linlingwanqing-commits/tp78_v2/mounriver_project/KEYBOARD_CH582M/HAL/include/HAL.h

#define __HAL_H
#ifdef __cplusplus
extern "C"
{
#endif
#include "CH58x_common.h"
typedef union {
    struct {
        unsigned char LeftBtn : 1;
        unsigned char RightBtn : 1;
        unsigned char MiddleBtn : 1;
        unsigned char Always1 : 1;
        unsigned char Xsignbit : 1;
        unsigned char Xspinbit : 1;
        unsigned char Xoverflow : 1;
        unsigned char Yoverflow : 1;
        signed char XMovement : 8;
        signed char YMovement : 8;
        signed char ZMovement : 8;
    };
    uint8_t data[4];
}Mouse_Data_t;
typedef union {
    struct {
        unsigned char LeftCTRL : 1;
        unsigned char LeftShift : 1;
        unsigned char LeftAlt : 1;
        unsigned char LeftGUI : 1;
        unsigned char RightCTRL : 1;
        unsigned char RightShift : 1;
        unsigned char RightAlt : 1;
        unsigned char RightGUI : 1;
        unsigned char Reserved : 8;
        unsigned char Key1 : 8;
        unsigned char Key2 : 8;
        unsigned char Key3 : 8;
        unsigned char Key4 : 8;
        unsigned char Key5 : 8;
        unsigned char Key6 : 8;
        };
    uint8_t data[8];
}Keyboard_Data_t;
#define MouseDat        ((Mouse_Data_t*)HIDMouse)
#define KeyboardDat     ((Keyboard_Data_t*)HIDKeyboard)
#include "config.h"
#include "TP78_MPR121_LIB.h"
#include "TP78_TPM_LIB.h"
#include "RTC.h"
#include "SLEEP.h"
#include "LED.h"
#include "KEY.h"
#include "BLE.h"
#include "FATFS.h"
#include "USB.h"
#include "PS2.h"
#include "HW_I2C.h"
#include "I2C_TP.h"
#include "MPR121.h"
#include "OLED.h"
#include "OLED_UI.h"
#include "RF_PHY.h"
#include "KEYBOARD.h"
#include "BATTERY.h"
#include "WS2812.h"
#include "LIGHTMAP.h"
#include "CORE.h"
#define MAIN_CIRCULATION_EVENT              0x0001
#define HAL_MOUSE_EVENT                     0x0002
#define HAL_KEYBOARD_EVENT                  0x0004
#define HAL_TOUCHBAR_EVENT                  0x0008
#define BATTERY_EVENT                       0x0010
#define WS2812_EVENT                        0x0020
#define OLED_UI_EVENT                       0x0040
#define MPR121_EVENT                        0x0080
#define MOTOR_STOP_EVENT                    0x0200
#define TPM_EVENT                           0x0400
#define HAL_REG_INIT_EVENT                  0x1000
#define HAL_TEST_EVENT                      0x2000
#define MESSAGE_UART                        0xD0    // UART message
#define UART0_MESSAGE                       (MESSAGE_UART|0 )    // UART0 message
#define UART1_MESSAGE                       (MESSAGE_UART|1 )    // UART1 message
#define USB_MESSAGE              		        0xB0    // USB message
#define KEY_MESSAGE                         0xA0    // KEY message
#define MOUSE_MESSAGE                       0xA1    // MOUSE message
#define VOL_MESSAGE                         0xA2    // VOL message
#define SWITCH_MESSAGE                      0xA3    // SWITCH message
#define HEARTBEAT_MESSAGE                   0xAA    // HEARTBEAT message
#define PASSKEY_MESSAGE                     0xC0    // passkey message
#define USB_WORK_MODE                       0
#define BLE_WORK_MODE                       1
#define RF_WORK_MODE                        2
#define USB_WITH_BLE_WORK_MODE              3
#define HID_KEYBOARD_DATA_LENGTH            8
#define HID_MOUSE_DATA_LENGTH               4
#define HID_VOLUME_DATA_LENGTH              1
#define HID_SWITCH_DATA_LENGTH              2
#define HID_DATA_LENGTH                     19
#define CODEFLASH_ADDR_START                (0x50000)
#define CODEFLASH_LENGTH                    (0x18000)     // 结束地址0x67FFF(预留0x7FFF)
#define SYS_PERIOD                          50            // 系统任务周期, 单位1ms
#define WS2812_TASK_PERIOD_MS               80            // WS2812任务周期, 单位1ms
#define DEFAULT_IDLE_MAX_PERIOD             (180 * (1000 / SYS_PERIOD)) // idle_cnt大于该值则进入屏保
#define DEFAULT_LP_MAX_PERIOD               (240 * (1000 / SYS_PERIOD)) // idle_cnt大于该值则进入低功耗模式
#define MOTOR_PIN                           GPIO_Pin_19
#define MOTOR_RUN()                         { if (g_Enable_Status.motor == TRUE) GPIOB_SetBits( MOTOR_PIN ); }
#define MOTOR_STOP()                        { GPIOB_ResetBits( MOTOR_PIN ); }
#define MOTOR_Init()                        { MOTOR_STOP(); GPIOB_ModeCfg( MOTOR_PIN, GPIO_ModeOut_PP_5mA ); }
#define MOTOR_GO()                          { MOTOR_RUN(); tmos_start_task( halTaskID, MOTOR_STOP_EVENT, MS1_TO_SYSTEM_TIME(100) ); }
#define USB_CAPSLOCK_LEDON_BIT              0x1
#define BLE_CAPSLOCK_LEDON_BIT              0x2
#define RF_CAPSLOCK_LEDON_BIT               0x4
#define UI_CAPSLOCK_LEDON_BIT               0x80
#define HOST_SYS_WINDOWS_LINUX              0x0
#define HOST_SYS_MAC                        0x1
typedef struct tag_uart_package
{
  tmos_event_hdr_t hdr;
  uint8            *pData;
} uartPacket_t;
typedef struct  SendMSG
{
  tmos_event_hdr_t hdr;
  void            *pData;
} SendMSG_t;
typedef struct _CapsLock_LEDOn_Status_t
{
    uint8_t usb : 1;
    uint8_t ble : 1;
    uint8_t rf : 1;
    uint8_t reserved : 4;
    uint8_t ui : 1;
}CapsLock_LEDOn_Status_t;
typedef struct _NumLock_LEDOn_Status_t
{
    uint8_t usb : 1;
    uint8_t ble : 1;
    uint8_t rf : 1;
    uint8_t reserved : 4;
    uint8_t ui : 1;
}NumLock_LEDOn_Status_t;
typedef struct _Ready_Status_t
{
    uint8_t usb : 1;
    uint8_t ble : 1;
    uint8_t rf : 1;
    uint8_t usb_ble : 1;  // 为TRUE表示发送USB，为FALSE表示发送蓝牙
    uint8_t usb_l : 1;
    uint8_t ble_l : 1;
    uint8_t rf_l : 1;
    uint8_t usb_ble_l : 1;
    uint8_t fatfs : 1;
    uint8_t keyboard_key_data : 1;
    uint8_t keyboard_mouse_data : 1;
    uint8_t ps2_data : 1;
    uint8_t i2ctp_data : 1;
}Ready_Status_t;
typedef struct _Enable_Status_t
{
    uint8_t usb : 1;
    uint8_t ble : 1;
    uint8_t rf : 1;
    uint8_t usb_ble : 1;
    uint8_t motor : 1;
    uint8_t tp : 1;
    uint8_t touchbar : 1;
    uint8_t paintedegg : 1;
    uint8_t touchbar_button : 1;
    uint8_t auto_mouse_click : 1;
    uint8_t sleep : 1;
    uint8_t tp_map_scroll : 1;
    uint8_t mac_mode : 1;
}Enable_Status_t;
extern UINT8 HID_DATA[HID_DATA_LENGTH];
extern UINT8* HIDMouse;
extern UINT8* HIDKeyboard;
extern UINT8* HIDVolume;
extern UINT8* HIDSwitch;
extern tmosTaskID halTaskID;
extern CapsLock_LEDOn_Status_t g_CapsLock_LEDOn_Status;
extern NumLock_LEDOn_Status_t g_NumLock_LEDOn_Status;
extern Ready_Status_t g_Ready_Status;
extern Enable_Status_t g_Enable_Status;
extern uint8_t g_TP_speed_div;
extern uint8_t g_Game_Mode;
extern uint8_t g_Test_Mode;
extern uint8_t wakeup_flag;
extern enum LP_Type g_lp_type;
extern uint8_t g_last_version[16];
extern uint32_t sys_time;
extern uint8_t g_auto_mouse_control_time;
uint8_t OnBoard_SendMsg(uint8_t registeredTaskID, uint8 event, uint8 state, void *data);
void HID_KEYBOARD_Process( void );
void HID_PS2TP_Process( void );
void HID_I2CTP_Process( void );
void HID_CapMouse_Process( void );
void HID_VOL_Process( void );
void SW_PaintedEgg_Process( void );
void SW_OLED_LEDStatus_Process( void );
void SW_OLED_UBStatus_Process( void );
void HW_Battery_Process( void );
void HW_WS2812_Process( void );
void HW_MODULE_DEMO_Process( void );
void HW_TouchBar_Process( void );
extern void FLASH_Init( void );
extern void HAL_Init( void );
extern tmosEvents HAL_ProcessEvent( tmosTaskID task_id, tmosEvents events );
extern void CH58X_BLEInit( void );
extern uint16 HAL_GetInterTempValue( void );
extern void Lib_Calibration_LSI( void );
#ifdef __cplusplus
}
#endif
