linlingwanqing-commits/tp78_v2/mounriver_project/KEYBOARD_CH582M/HAL/KEYBOARD.c

/********************************** (C) COPYRIGHT *******************************
 * File Name          : KEYBOARD.c
 * Author             : ChnMasterOG
 * Version            : V2.0
 * Date               : 2022/12/1
 * Description        : 机械键盘驱动源文件
 * Copyright (c) 2023 ChnMasterOG
 * SPDX-License-Identifier: GPL-3.0
 *******************************************************************************/

#include "HAL.h"
#include "snake.h"

const uint32_t Row_Pin[ROW_SIZE] = {GPIO_Pin_6, GPIO_Pin_5, GPIO_Pin_3, GPIO_Pin_2, GPIO_Pin_1};   //row 5 - 其它键盘布局需修改此处
const uint32_t Colum_Pin[COL_SIZE] = {GPIO_Pin_4, GPIO_Pin_5, GPIO_Pin_6, GPIO_Pin_0, GPIO_Pin_1, GPIO_Pin_2, GPIO_Pin_3,
                                      GPIO_Pin_15, GPIO_Pin_14, GPIO_Pin_13, GPIO_Pin_12, GPIO_Pin_11, GPIO_Pin_9,};   //colum 13 - 其它键盘布局需修改此处
//row*colum = 5*13 = 65
const uint8_t KeyArrary[ROW_SIZE][COL_SIZE] = {
const uint8_t KeyArrary[ROW_SIZE][COL_SIZE] = {
    // ROW0: Esc, 1, 2, 3, 4, 5, 6, 7, 8, 9, 0, \, Backspace
    { KEY_ESCAPE,   KEY_1,      KEY_2,      KEY_3,      KEY_4,      KEY_5,      KEY_6,      KEY_7,      KEY_8,      KEY_9,      KEY_0,      KEY_Backslash,  KEY_BACKSPACE },
    
    // ROW1: Tab, Q, W, E, R, T, Y, U, I, O, P, [, ]
    { KEY_TAB,      KEY_Q,      KEY_W,      KEY_E,      KEY_R,      KEY_T,      KEY_Y,      KEY_U,      KEY_I,      KEY_O,      KEY_P,      KEY_LSbrackets, KEY_RSbrackets },
    
    // ROW2: CapsLock, A, S, D, F, G, H, J, K, L, ;, ', Enter
    { KEY_CapsLock, KEY_A,      KEY_S,      KEY_D,      KEY_F,      KEY_G,      KEY_H,      KEY_J,      KEY_K,      KEY_L,      KEY_Semicolon, KEY_Quotation,  KEY_ENTER },
    
    // ROW3: Shift, Z, X, C, V, B, N, M, ,, ., ↑, /, Shift
    { KEY_LeftShift,KEY_Z,      KEY_X,      KEY_C,      KEY_V,      KEY_B,      KEY_N,      KEY_M,      KEY_Comma,  KEY_FullStop,KEY_UpArrow, KEY_Slash,      KEY_RightShift },
    
    // ROW4: Ctrl, Delete, Win, Alt, 空格, Fn, Menu, 空格, ←, ↓, →, Ctrl, (第13列留空)
    { KEY_LeftCTRL, KEY_Delete, KEY_LeftGUI, KEY_LeftAlt, KEY_SPACEBAR, KEY_Fn,  KEY_Fn,   KEY_SPACEBAR, KEY_LeftArrow, KEY_DownArrow, KEY_RightArrow, KEY_RightCTRL,},
};
const uint8_t Extra_KeyArrary[ROW_SIZE][COL_SIZE] = {
    // COL0 COL1 COL2 COL3 COL4 COL5 COL6 COL7 COL8 COL9 COL10 COL11 COL12
    { KEY_None, KEY_None, KEY_None, KEY_None, KEY_None, KEY_None, KEY_None, KEY_None, KEY_None, KEY_None, KEY_None, KEY_None, KEY_None },  // ROW0
    { KEY_None, KEY_None, KEY_None, KEY_None, KEY_None, KEY_None, KEY_None, KEY_None, KEY_None, KEY_None, KEY_None, KEY_None, KEY_None },  // ROW1
    { KEY_None, KEY_None, KEY_None, KEY_None, KEY_None, KEY_None, KEY_None, KEY_None, KEY_None, KEY_None, KEY_None, KEY_None, KEY_None },  // ROW2
    { KEY_None, KEY_None, KEY_None, KEY_None, KEY_None, KEY_None, KEY_None, KEY_None, KEY_None, KEY_None, KEY_None, KEY_None, KEY_None },  // ROW3
    { KEY_None, KEY_None, KEY_None, KEY_None, KEY_None, KEY_None, KEY_None, KEY_None, KEY_None, KEY_None, KEY_None, KEY_None, KEY_None },  // ROW4
};
const uint8_t SP_KeyArrary[SP_KEY_NUMBER][8] = {
    /* 1 */ { 0x01, 0x0, KEY_C,      0x0, 0x0, 0x0, 0x0, 0x0 },  // Ctrl+C  复制
    /* 2 */ { 0x01, 0x0, KEY_V,      0x0, 0x0, 0x0, 0x0, 0x0 },  // Ctrl+V  粘贴
    /* 3 */ { 0x01, 0x0, KEY_X,      0x0, 0x0, 0x0, 0x0, 0x0 },  // Ctrl+X  剪切
    /* 4 */ { 0x01, 0x0, KEY_Z,      0x0, 0x0, 0x0, 0x0, 0x0 },  // Ctrl+Z  撤销
    /* 5 */ { 0x01, 0x0, KEY_Y,      0x0, 0x0, 0x0, 0x0, 0x0 },  // Ctrl+Y  重做
    /* 6 */ { 0x08, 0x0, KEY_X,      0x0, 0x0, 0x0, 0x0, 0x0 },  // Win+X   高级菜单
    /* 7 */ { 0x01, 0x0, KEY_W,      0x0, 0x0, 0x0, 0x0, 0x0 },  // Ctrl+W  关闭标签页
};
const uint8_t Key_To_LEDNumber[ROW_SIZE][COL_SIZE] = {
    // ROW0: 左→右（正向）
    { 0,   1,   2,   3,   4,   5,   6,   7,   8,   9,   10,  11,  12 },
    
    // ROW1: 右→左（反向）
    { 25,  24,  23,  22,  21,  20,  19,  18,  17,  16,  15,  14,  13 },
    
    // ROW2: 左→右（正向）
    { 26,  27,  28,  29,  30,  31,  32,  33,  34,  35,  36,  37,  38 },
    
    // ROW3: 右→左（反向）
    { 51,  50,  49,  48,  47,  46,  45,  44,  43,  42,  41,  40,  39 },
    
    // ROW4: 左→右（正向）
    { 52,  53,  54,  55,  56,  57,  58,  59,  60,  61,  62,  63,  64 },
};
uint32_t Row_Pin_ALL = 0, Colum_Pin_ALL = 0;
uint8_t CustomKey[ROW_SIZE][COL_SIZE];  //自定义按键层
uint8_t Extra_CustomKey[ROW_SIZE][COL_SIZE];   //自定义额外按键层
uint8_t KeyMatrix[ROW_SIZE][COL_SIZE] = { 0 };  //按键矩阵-标记按下和未按下
uint8_t Extra_KeyMatrix[ROW_SIZE][COL_SIZE] = { 0 };  //额外层按键矩阵-标记按下和未按下
uint8_t SP_Key_Map[SP_KEY_NUMBER][8] = { 0 }; //复合按键
Keyboard_Status_t g_keyboard_status;
Capslock_Status_t g_capslock_status;

static uint8_t (*KeyArr_Ptr)[COL_SIZE] = CustomKey;

/*******************************************************************************
 * Function Name  : DATAFLASH_Read_KeyArray
 * Description    : 从DataFlash读取按键矩阵
 * Input          : None
 * Return         : None
 *******************************************************************************/
void DATAFLASH_Read_KeyArray( void )
{
  HAL_Fs_Read_keyboard_mat("0:keyboard_mat.txt", (uint8_t*)CustomKey);
  HAL_Fs_Read_keyboard_mat("0:keyboard_ext_mat.txt", (uint8_t*)Extra_CustomKey);
}

/*******************************************************************************
 * Function Name  : DATAFLASH_Write_KeyArray
 * Description    : 将按键矩阵写入DataFlash
 * Input          : None
 * Return         : None
 *******************************************************************************/
void DATAFLASH_Write_KeyArray( void )
{
  HAL_Fs_Write_keyboard_mat("0:keyboard_mat.txt", (const uint8_t*)CustomKey);
  HAL_Fs_Write_keyboard_mat("0:keyboard_ext_mat.txt", (const uint8_t*)Extra_CustomKey);
}

/*******************************************************************************
 * Function Name  : KEYBOARD_Reset
 * Description    : 重置FLASH
 * Input          : None
 * Return         : None
 *******************************************************************************/
void KEYBOARD_Reset( void )
{
  uint16_t param[] = { 0, 1, 0, 0,
                       ALG_PARAM_MAGIC,
                       CAP_MOUSE_TOU_THRESH, CAP_MOUSE_REL_THRESH, CAP_MOUSE_MOVE_SPEED,
                       TOUCHBAR_TOU_THRESH, TOUCHBAR_REL_THRESH,
                       DOUBLE_TOUCH_CNT, LONG_TOUCH_CNT,
                       1, LED_DEFAULT_BRIGHTNESS, 2,  // RF频率默认2.405G
                       0, 180, 240, 10, 0, 0,
                       HOST_SYS_WINDOWS_LINUX,
  };

  memcpy(CustomKey, KeyArrary, COL_SIZE*ROW_SIZE);
  memcpy(Extra_CustomKey, Extra_KeyArrary, COL_SIZE*ROW_SIZE);
  memcpy(SP_Key_Map, SP_KeyArrary, SP_KEY_NUMBER*8);
  DATAFLASH_Write_KeyArray( );
  HAL_Fs_Write_keyboard_spkey((uint8_t*)SP_Key_Map);
  HAL_Fs_Create_keyboard_cfg(sizeof(param)/sizeof(uint16_t), param);
  HAL_Fs_Create_readme();
}

/*******************************************************************************
 * Function Name  : KEYBOARD_ChangeKey
 * Description    : 键盘交换2个按键
 * Input          : dst_key - 目标键, src_key - 原始键
 * Return         : None
 *******************************************************************************/
void KEYBOARD_ChangeKey( uint8_t dst_key, uint8_t src_key )
{
  uint8_t i = COL_SIZE*ROW_SIZE;
  uint8_t* memaddr = &CustomKey[0][0];
  while (i) {
    --i;
    /* 交换src键和dst键 */
    if ( *(memaddr + i) == src_key ) *(memaddr + i) = dst_key;
    else if ( *(memaddr + i) == dst_key ) *(memaddr + i) = src_key;
  }
  DATAFLASH_Write_KeyArray( );
}

/*******************************************************************************
 * Function Name  : KEYBOARD_Custom_Function
 * Description    : 键盘定制化功能(检测Fn键触发的相关功能)
 * Input          : None
 * Return         : 如果不需要发送按键信息则返回0
 *******************************************************************************/
UINT8 KEYBOARD_Custom_Function( void )
{
  static uint16_t last_state = 0;
  static uint32_t press_time = 0;
  static uint8_t Fn_Mode = 0;
  static uint8_t Fn_cnt = 0;  // 4/2/1/1 bit for Reset/ChangeKey/SaveDevices/Reserved
  static uint8_t src_key = 0, dst_key = 0;

  if ( g_keyboard_status.Fn == TRUE && KeyboardDat->Key2 == KEY_None ) { // 按下Fn+1个键或者只有Fn键
    last_state = 1;
    press_time = sys_time;
    if ( KeyboardDat->Key1 == KEY_None && Fn_Mode == Fn_Mode_None ) { // 键盘布局复位
      Fn_Mode = Fn_Mode_Reset;
      Fn_cnt &= 0xF0;   // 清除其余计数器
    } else if ( Fn_Mode == Fn_Mode_ChangeKey ) {  // 设置改键 - 按Fn+src和Fn+dst
      if ( Fn_cnt == 0x04 ) src_key = KeyboardDat->Key1;
      else if ( Fn_cnt == 0x08 ) dst_key = KeyboardDat->Key1;
    } else if ( KeyboardDat->Key1 == KEY_C && Fn_Mode != Fn_Mode_ChangeKey ) { // 设置改键 - 先按Fn+C
      Fn_Mode = Fn_Mode_ChangeKey;
      Fn_cnt &= 0x0C;
    } else if ( KeyboardDat->Key1 == KEY_O && Fn_Mode != Fn_Mode_Enter_Cfg ) { // 配置参数模式
      Fn_Mode = Fn_Mode_Enter_Cfg;
      Fn_cnt = 0;
    } else if ( KeyboardDat->Key1 == KEY_R && Fn_Mode != Fn_Mode_SoftReset ) { // 软件复位模式
      Fn_Mode = Fn_Mode_SoftReset;
      Fn_cnt = 0;
    } else if ( KeyboardDat->Key1 == KEY_Z && Fn_Mode != Fn_Mode_Test ) { // 测试模式
      Fn_Mode = Fn_Mode_Test;
      Fn_cnt = 0;
    } else if ( KeyboardDat->Key1 == KEY_ESCAPE && Fn_Mode != Fn_Mode_RFJumptoBoot ) { // RF发送0x7A让接收器进BOOT
      Fn_Mode = Fn_Mode_RFJumptoBoot;
      Fn_cnt = 0;
    } else if ( KeyboardDat->Key1 == KEY_B && Fn_Mode != Fn_Mode_JumpBoot ) { // 跳转BOOT模式
      Fn_Mode = Fn_Mode_JumpBoot;
      Fn_cnt = 0;
    } else if ( KeyboardDat->Key1 == KEY_Subtraction && Fn_Mode != Fn_Mode_VolumeDown ) { // 音量减模式
      Fn_Mode = Fn_Mode_VolumeDown;
      HIDVolume[0] |= Volume_Decr;
      HID_VOL_Process();
      Fn_cnt = 0;
    } else if ( KeyboardDat->Key1 == KEY_Equal && Fn_Mode != Fn_Mode_VolumeUp ) { // 音量加模式
      Fn_Mode = Fn_Mode_VolumeUp;
      HIDVolume[0] |= Volume_Incr;
      HID_VOL_Process();
      Fn_cnt = 0;
    } else if ( KeyboardDat->Key1 == KEY_Delete && Fn_Mode != Fn_Mode_PaintedEgg ) { // 彩蛋模式
      Fn_Mode = Fn_Mode_PaintedEgg;
      Fn_cnt = 0;
    } else if ( KeyboardDat->Key1 == KEY_T && Fn_Mode != Fn_Mode_DisEnableTP ) { // 使能/失能小红点
      Fn_Mode = Fn_Mode_DisEnableTP;
      Fn_cnt = 0;
    } else if ( KeyboardDat->Key1 == KEY_Y && Fn_Mode != Fn_Mode_DisEnableTouchbar ) { // 使能/失能触摸条
      Fn_Mode = Fn_Mode_DisEnableTouchbar;
      Fn_cnt = 0;
    } else if ( KeyboardDat->Key1 == KEY_F10 && Fn_Mode != Fn_Mode_USBMode ) { // 切换USB模式
      Fn_Mode = Fn_Mode_USBMode;
      Fn_cnt = 0;
    } else if ( KeyboardDat->Key1 == KEY_F11 && Fn_Mode != Fn_Mode_BLEMode ) { // 切换蓝牙模式
      Fn_Mode = Fn_Mode_BLEMode;
      Fn_cnt = 0;
    } else if ( KeyboardDat->Key1 == KEY_F12 && Fn_Mode != Fn_Mode_RFMode ) { // 切换RF模式
      Fn_Mode = Fn_Mode_RFMode;
      Fn_cnt = 0;
    } else if ( KeyboardDat->Key1 == KEY_F9 && Fn_Mode != Fn_Mode_USBBLEMode ) { // 切换USB和BLE共存模式
      Fn_Mode = Fn_Mode_USBBLEMode;
      Fn_cnt = 0;
    } else if ( KeyboardDat->Key1 == KEY_U && Fn_Mode != Fn_Mode_UDiskMode ) { // 开启U盘模式
      Fn_Mode = Fn_Mode_UDiskMode;
      Fn_cnt = 0;
    } else if ( KeyboardDat->Key1 == KEY_G && Fn_Mode != Fn_Mode_GameMode ) { // 开启性能模式
      Fn_Mode = Fn_Mode_GameMode;
      Fn_cnt = 0;
    } else if ( KeyboardDat->Key1 == KEY_PageUp && Fn_Mode != Fn_Mode_Select_USB_Send ) { // 共存模式下选择USB发送
      Fn_Mode = Fn_Mode_Select_USB_Send;
      Fn_cnt = 0;
    } else if ( KeyboardDat->Key1 == KEY_PageDown && Fn_Mode != Fn_Mode_Select_BLE_Send ) { // 共存模式下选择BLE发送
      Fn_Mode = Fn_Mode_Select_BLE_Send;
      Fn_cnt = 0;
    } else if ( KeyboardDat->Key1 == KEY_0 && Fn_Mode != Fn_Mode_BLE_ClearSNV ) { // 清除蓝牙SNV信息
      Fn_Mode = Fn_Mode_BLE_ClearSNV;
      Fn_cnt = 0;
    } else if ( KeyboardDat->Key1 == KEY_1 && Fn_Mode != Fn_Mode_SelectDevice1 ) { // 切换至设备1
      Fn_Mode = Fn_Mode_SelectDevice1;
      Fn_cnt = 0;
    } else if ( KeyboardDat->Key1 == KEY_2 && Fn_Mode != Fn_Mode_SelectDevice2 ) { // 切换至设备2
      Fn_Mode = Fn_Mode_SelectDevice2;
      Fn_cnt = 0;
    } else if ( KeyboardDat->Key1 == KEY_3 && Fn_Mode != Fn_Mode_SelectDevice3 ) { // 切换至设备3
      Fn_Mode = Fn_Mode_SelectDevice3;
      Fn_cnt = 0;
    } else if ( KeyboardDat->Key1 == KEY_4 && Fn_Mode != Fn_Mode_SelectDevice4 ) { // 切换至设备4
      Fn_Mode = Fn_Mode_SelectDevice4;
      Fn_cnt = 0;
    } else if ( KeyboardDat->Key1 == KEY_F1 && Fn_Mode != Fn_Mode_LED_Style1 ) { // 背光模式1
      Fn_Mode = Fn_Mode_LED_Style1;
      Fn_cnt = 0;
    } else if ( KeyboardDat->Key1 == KEY_F2 && Fn_Mode != Fn_Mode_LED_Style2 ) { // 背光模式2
      Fn_Mode = Fn_Mode_LED_Style2;
      Fn_cnt = 0;
    } else if ( KeyboardDat->Key1 == KEY_F3 && Fn_Mode != Fn_Mode_LED_Style3 ) { // 背光模式3
      Fn_Mode = Fn_Mode_LED_Style3;
      Fn_cnt = 0;
    } else if ( KeyboardDat->Key1 == KEY_F4 && Fn_Mode != Fn_Mode_LED_Style4 ) { // 背光模式4
      Fn_Mode = Fn_Mode_LED_Style4;
      Fn_cnt = 0;
    } else if ( KeyboardDat->Key1 == KEY_F5 && Fn_Mode != Fn_Mode_LED_Style5 ) { // 背光模式5
      Fn_Mode = Fn_Mode_LED_Style5;
      Fn_cnt = 0;
    } else if ( KeyboardDat->Key1 == KEY_F6 && Fn_Mode != Fn_Mode_LED_Style6 ) { // 背光模式6
      Fn_Mode = Fn_Mode_LED_Style6;
      Fn_cnt = 0;
    } else {
      if ( Fn_Mode == Fn_Mode_Reset ) return 0;
      if ( Fn_Mode != Fn_Mode_None && KeyboardDat->Key1 == KEY_None ) { // 先松开其他按键(后松开Fn)
        goto fn_do_operations;
      }
      Fn_Mode = Fn_Mode_None;
      Fn_cnt = 0;
    }
    return 0;
  } else if ( last_state > 0 && g_keyboard_status.Fn == FALSE ) {  // 松开Fn执行指令
    fn_do_operations:
    switch ( Fn_Mode ) {
      case Fn_Mode_Reset: { // 按下5次Fn重置按键
        Fn_cnt += 0x10;
        if ( Fn_cnt == 0x50 ) {
          Fn_cnt = 0;
          Fn_Mode = Fn_Mode_None;
#if (defined HAL_WDG) && (HAL_WDG == TRUE)
          WWDG_ResetCfg(DISABLE); // 关看门狗
#endif
          KEYBOARD_Reset( );
#if (defined HAL_WDG) && (HAL_WDG == TRUE)
          WWDG_ResetCfg(ENABLE);  // 开看门狗
#endif
          OLED_UI_add_SHOWINFO_task("Reset OK!");
          OLED_UI_add_CANCELINFO_delay_task(3000);
        } else if ( Fn_cnt >= 0x30 ) {
          OLED_UI_add_SHOWINFO_task("%d/5 Reset", Fn_cnt >> 4);
          OLED_UI_add_CANCELINFO_delay_task(1500);
        } else if ( Fn_cnt == 0x20 && sys_time - press_time >= 3 * (1000 / SYS_PERIOD) ) {  // 第二下Fn长按进board boot --- 防止误擦除固件，该功能暂时屏蔽
          //-APPJumpBoot();
        }
        break;
      }
      case Fn_Mode_ChangeKey: { // Fn+C交换按键
        Fn_cnt += 0x04;
        if ( Fn_cnt == 0x0C ) {
          Fn_cnt = 0;
          Fn_Mode = Fn_Mode_None;
          OLED_UI_add_SHOWINFO_task("Change OK!");
          OLED_UI_add_CANCELINFO_delay_task(3000);
          KEYBOARD_ChangeKey( dst_key, src_key );
        }
        break;
      }
      case Fn_Mode_Enter_Cfg: { // Fn+O参数配置
        Fn_Mode = Fn_Mode_None;
        if (g_keyboard_status.enter_cfg) {  // 退出界面配置
#ifdef HAL_OLED
#ifdef OLED_0_66
          OLED_UI_add_CLEARPAGE_task(2, 5);
#endif
#ifdef OLED_0_91
          // TODO
#endif
#endif
          g_keyboard_status.enter_cfg = 0;
        } else {  // 进入界面配置
#ifdef HAL_OLED
          OLED_UI_draw_menu(OLED_UI_MENU_REFRESH);
#endif
          g_keyboard_status.enter_cfg = 1;
        }
        break;
      }
      case Fn_Mode_Test: {  // Fn+Z测试
        Fn_Mode = Fn_Mode_None;
        g_Test_Mode = !g_Test_Mode;
        if (g_Test_Mode)
          OLED_UI_add_SHOWINFO_task("Test ON!");
        else
          OLED_UI_add_SHOWINFO_task("Test OFF!");
        OLED_UI_add_CANCELINFO_delay_task(3000);
        break;
      }
      case Fn_Mode_SoftReset: { // Fn+R软件复位
        Fn_Mode = Fn_Mode_None;
        SoftReset();
        break;
      }
      case Fn_Mode_RFJumptoBoot: {  // Fn+ESC发送0x7A让接收器进BOOT
        Fn_Mode = Fn_Mode_None;
        if (g_Enable_Status.rf == TRUE) {
          tmos_set_event( RFTaskId, SBP_RF_JUMPBOOT_REPORT_EVT );  // RF JUMPBOOT事件
        }
        break;
      }
      case Fn_Mode_JumpBoot: {  // Fn+B跳转kboot
        enter_boot_mode:
        Fn_Mode = Fn_Mode_None;
        APPJumpKBoot();
        break;
      }
      case Fn_Mode_VolumeDown: {  // Fn+减号减小音量 - 松开停止
        Fn_Mode = Fn_Mode_None;
        HIDVolume[0] &= ~Volume_Decr;
        HID_VOL_Process();
        break;
      }
      case Fn_Mode_VolumeUp: {  // Fn+加号增加音量 - 松开停止
        Fn_Mode = Fn_Mode_None;
        HIDVolume[0] &= ~Volume_Incr;
        HID_VOL_Process();
        break;
      }
      case Fn_Mode_PaintedEgg: {  // Fn+Delete彩蛋
        Fn_Mode = Fn_Mode_None;
        if (g_Enable_Status.paintedegg == FALSE) {
          g_keyboard_status.changeBL = TRUE;
          led_style_func = WS2812_Style_Custom; // 彩蛋背光
          Snake_Init();
          OLED_UI_show_version(1);  // 显示版本信息
          g_Enable_Status.paintedegg = TRUE;
        } else {
          OLED_UI_show_version(0);  // 取消显示版本信息
          led_style_func = WS2812_Style_Off;
          g_Enable_Status.paintedegg = FALSE;
          tmos_start_task( halTaskID, HAL_KEYBOARD_EVENT, MS1_TO_SYSTEM_TIME(5) ); // 重新开启键盘线程
        }
        break;
      }
      case Fn_Mode_DisEnableTP: { // Fn+T关闭/开启小红点
        Fn_Mode = Fn_Mode_None;
        g_Enable_Status.tp = !g_Enable_Status.tp;
        if ( g_Enable_Status.tp == TRUE ) OLED_UI_add_SHOW_ICONINFO_task(OLED_UI_ICON_TP_IDX, " ON");
        else OLED_UI_add_SHOW_ICONINFO_task(OLED_UI_ICON_TP_IDX, " OFF");
        OLED_UI_add_CANCELINFO_delay_task(2000);
        break;
      }
      case Fn_Mode_DisEnableTouchbar: { // Fn+Y关闭/开启触摸条
        Fn_Mode = Fn_Mode_None;
        g_Enable_Status.touchbar = !g_Enable_Status.touchbar;
        if ( g_Enable_Status.touchbar == TRUE ) OLED_UI_add_SHOW_ICONINFO_task(OLED_UI_ICON_TOUCHBAR_IDX, " ON");
        else OLED_UI_add_SHOW_ICONINFO_task(OLED_UI_ICON_TOUCHBAR_IDX, " OFF");
        OLED_UI_add_CANCELINFO_delay_task(2000);
        break;
      }
      case Fn_Mode_USBMode: { // Fn+F10切换USB模式
        Fn_Mode = Fn_Mode_None;
        if (g_Enable_Status.usb == TRUE) {
          OLED_UI_add_SHOWINFO_task("USB Mode");
          OLED_UI_add_CANCELINFO_delay_task(2000);
          break;
        }
        uint16_t Usb_mode = 0;
        HAL_Fs_Write_keyboard_cfg(FS_LINE_WORK_MODE, 1, &Usb_mode);
        SoftReset();
        break;
      }
      case Fn_Mode_BLEMode: { // Fn+F11切换蓝牙模式
        Fn_Mode = Fn_Mode_None;
        if (g_Enable_Status.ble == TRUE) {
          OLED_UI_add_SHOWINFO_task("BLE Mode");
          OLED_UI_add_CANCELINFO_delay_task(2000);
          break;
        }
        uint16_t Ble_mode = 1;
        HAL_Fs_Write_keyboard_cfg(FS_LINE_WORK_MODE, 1, &Ble_mode);
        SoftReset();
        break;
      }
      case Fn_Mode_RFMode: { // Fn+F12切换RF模式
        Fn_Mode = Fn_Mode_None;
        if (g_Enable_Status.rf == TRUE) {
          OLED_UI_add_SHOWINFO_task("RF Mode");
          OLED_UI_add_CANCELINFO_delay_task(2000);
          break;
        }
        uint16_t Rf_mode = 2;
        HAL_Fs_Write_keyboard_cfg(FS_LINE_WORK_MODE, 1, &Rf_mode);
        SoftReset();
        break;
      }
      case Fn_Mode_USBBLEMode: { // Fn+F9切换USB和BLE共存模式
        Fn_Mode = Fn_Mode_None;
        if (g_Enable_Status.usb_ble == TRUE) {
          OLED_UI_add_SHOWINFO_task("USB + BLE");
          OLED_UI_add_CANCELINFO_delay_task(2000);
          break;
        }
        uint16_t USB_with_BLE_mode = 3;
        HAL_Fs_Write_keyboard_cfg(FS_LINE_WORK_MODE, 1, &USB_with_BLE_mode);
        SoftReset();
        break;
      }
      case Fn_Mode_UDiskMode: { // Fn+U开启U盘模式
        Fn_Mode = Fn_Mode_None;
        uint16_t Usb_mode = 0;
        uint16_t Udisk_mode = 1;
        HAL_Fs_Write_keyboard_cfg(FS_LINE_WORK_MODE, 1, &Usb_mode);
        HAL_Fs_Write_keyboard_cfg(FS_LINE_UDISK_MODE, 1, &Udisk_mode);
        SoftReset();
        break;
      }
      case Fn_Mode_GameMode: { // Fn+G开关性能模式
        Fn_Mode = Fn_Mode_None;
        g_Game_Mode = !g_Game_Mode;
        if (g_Game_Mode == FALSE) {
          OLED_UI_add_SHOWINFO_task("G Mode OFF");
          OLED_UI_add_CANCELINFO_delay_task(2000);
          tmos_start_task( halTaskID, MAIN_CIRCULATION_EVENT, 10 ); // 主循环
#if ((defined HAL_MPR121_CAPMOUSE) && (HAL_MPR121_CAPMOUSE == TRUE)) || ((defined HAL_MPR121_TOUCHBAR) && (HAL_MPR121_TOUCHBAR == TRUE))
          tmos_start_task( halTaskID, MPR121_EVENT, MS1_TO_SYSTEM_TIME(30) );  // MPR121
#endif
#if ((defined HAL_PS2) && (HAL_PS2 == TRUE)) || ((defined HAL_I2C_TP) && (HAL_I2C_TP == TRUE)) || ((defined HAL_MPR121_CAPMOUSE) && (HAL_MPR121_CAPMOUSE == TRUE))
          tmos_start_task( halTaskID, HAL_MOUSE_EVENT, MS1_TO_SYSTEM_TIME(40) ); // 鼠标事件
#endif
#if (defined HAL_OLED) && (HAL_OLED == TRUE)
          tmos_start_task( halTaskID, OLED_UI_EVENT, MS1_TO_SYSTEM_TIME(60) );  // OLED UI
#endif
#if ((defined HAL_HW_I2C) && (HAL_HW_I2C == TRUE)) && ((defined HAL_TPM) && (HAL_TPM == TRUE))
          tmos_start_task( halTaskID, TPM_EVENT, MS1_TO_SYSTEM_TIME(30) );  // 扩展模块
#endif
        } else {
          OLED_PRINT("G Mode ON");
        }
        break;
      }
      case Fn_Mode_Select_USB_Send: { // Fn+PgUp选择发送USB报文
        Fn_Mode = Fn_Mode_None;
        if (g_Enable_Status.usb_ble == TRUE) {
          g_Ready_Status.usb_ble_l = TRUE;
        }
        break;
      }
      case Fn_Mode_Select_BLE_Send: { // Fn+PgDn选择发送BLE报文
        Fn_Mode = Fn_Mode_None;
        if (g_Enable_Status.usb_ble == TRUE) {
          g_Ready_Status.usb_ble_l = FALSE;
        }
        break;
      }
      case Fn_Mode_BLE_ClearSNV: {  // Fn+0清除蓝牙SNV信息
        Fn_Mode = Fn_Mode_None;
        uint32_t SNV_size, p_addr = BLE_SNV_ADDR;
        uint16_t i;
        uint8_t e_buf[4] = { 0xFF, 0xFF, 0xFF, 0xFF };
#if (defined HAL_WDG) && (HAL_WDG == TRUE)
        WWDG_ResetCfg(DISABLE); // 关看门狗
#endif
        SNV_size = 0x8000 - BLE_SNV_ADDR;
        EEPROM_ERASE(BLE_SNV_ADDR, SNV_size);
        SNV_size >>= 2;
        for (i = 0; i < SNV_size; i++) {
          EEPROM_WRITE(p_addr, e_buf, 4); // 填充0xFF
          p_addr += 4;
        }
#if (defined HAL_WDG) && (HAL_WDG == TRUE)
        WWDG_ResetCfg(ENABLE);  // 开看门狗
#endif
        if (g_Enable_Status.ble == TRUE) {
          OLED_PRINT("Erase OK");
          DelayMs(50);
          SoftReset();
        } else {
          OLED_UI_add_SHOWINFO_task("Erase OK");
          OLED_UI_add_CANCELINFO_delay_task(2000);
        }
        break;
      }
      case Fn_Mode_SelectDevice1 ... Fn_Mode_SelectDevice4: { // 按Fn+1~4切换设备
        uint8_t new_device = Fn_Mode - Fn_Mode_SelectDevice1;
        Fn_Mode = Fn_Mode_None;
        DATAFLASH_Write_DeviceID(new_device);
        SoftReset();
        break;
      }
      case Fn_Mode_LED_Style1: {
        Fn_Mode = Fn_Mode_None;
        g_keyboard_status.changeBL = TRUE;
#ifdef OLED_0_91
        OLED_UI_add_SHOWSTRING_task(20, 1, "S0");
#endif
#ifdef OLED_0_66
        OLED_UI_add_SHOW_ICONINFO_task(OLED_UI_ICON_LED_STYLE_IDX, " OFF");
        OLED_UI_add_CANCELINFO_delay_task(2000);
#endif
        led_style_func = WS2812_Style_Custom;  // Fn+F1 - 关闭背光(背光保持不变)
#if (defined HAL_TPM) && (HAL_TPM == TRUE) && (defined HAL_HW_I2C) && (HAL_HW_I2C == TRUE)
        TPM_notify_backlight_data(BACKLIGHT_MODE_OFF);
#endif
        break;
      }
      case Fn_Mode_LED_Style2: {
        Fn_Mode = Fn_Mode_None;
        g_keyboard_status.changeBL = TRUE;
#ifdef OLED_0_91
        OLED_UI_add_SHOWSTRING_task(20, 1, "S1");
#endif
#ifdef OLED_0_66
        OLED_UI_add_SHOW_ICONINFO_task(OLED_UI_ICON_LED_STYLE_IDX, "Breath");
        OLED_UI_add_CANCELINFO_delay_task(2000);
#endif
        led_style_func = WS2812_Style_Breath;  // Fn+F2 - 背光使用呼吸灯模式
#if (defined HAL_TPM) && (HAL_TPM == TRUE) && (defined HAL_HW_I2C) && (HAL_HW_I2C == TRUE)
        TPM_notify_backlight_data(BACKLIGHT_MODE_BREATH);
#endif
        break;
      }
      case Fn_Mode_LED_Style3: {
        Fn_Mode = Fn_Mode_None;
        g_keyboard_status.changeBL = TRUE;
#ifdef OLED_0_91
        OLED_UI_add_SHOWSTRING_task(20, 1, "S2");
#endif
#ifdef OLED_0_66
        OLED_UI_add_SHOW_ICONINFO_task(OLED_UI_ICON_LED_STYLE_IDX, "Waterful");
        OLED_UI_add_CANCELINFO_delay_task(2000);
#endif
        led_style_func = WS2812_Style_Waterful;  // Fn+F3 - 背光使用流水灯模式
#if (defined HAL_TPM) && (HAL_TPM == TRUE) && (defined HAL_HW_I2C) && (HAL_HW_I2C == TRUE)
        TPM_notify_backlight_data(BACKLIGHT_MODE_WATERFUL);
#endif
        break;
      }
      case Fn_Mode_LED_Style4: {
        Fn_Mode = Fn_Mode_None;
        g_keyboard_status.changeBL = TRUE;
#ifdef OLED_0_91
        OLED_UI_add_SHOWSTRING_task(20, 1, "S3");
#endif
#ifdef OLED_0_66
        OLED_UI_add_SHOW_ICONINFO_task(OLED_UI_ICON_LED_STYLE_IDX, "Touch");
        OLED_UI_add_CANCELINFO_delay_task(2000);
#endif
        led_style_func = WS2812_Style_Touch;  // Fn+F4 - 背光使用触控呼吸灯模式
#if (defined HAL_TPM) && (HAL_TPM == TRUE) && (defined HAL_HW_I2C) && (HAL_HW_I2C == TRUE)
        TPM_notify_backlight_data(BACKLIGHT_MODE_TOUCH);
#endif
        break;
      }
      case Fn_Mode_LED_Style5: {
        Fn_Mode = Fn_Mode_None;
        g_keyboard_status.changeBL = TRUE;
#ifdef OLED_0_91
        OLED_UI_add_SHOWSTRING_task(20, 1, "S4");
#endif
#ifdef OLED_0_66
        OLED_UI_add_SHOW_ICONINFO_task(OLED_UI_ICON_LED_STYLE_IDX, "Rainbow");
        OLED_UI_add_CANCELINFO_delay_task(2000);
#endif
        led_style_func = WS2812_Style_Rainbow;  // Fn+F5 - 背光使用彩虹灯模式
#if (defined HAL_TPM) && (HAL_TPM == TRUE) && (defined HAL_HW_I2C) && (HAL_HW_I2C == TRUE)
        TPM_notify_backlight_data(BACKLIGHT_MODE_RAINBOW);
#endif
        break;
      }
      case Fn_Mode_LED_Style6: {
        Fn_Mode = Fn_Mode_None;
        g_keyboard_status.changeBL = TRUE;
#ifdef OLED_0_91
        OLED_UI_add_SHOWSTRING_task(20, 1, "S5");
#endif
#ifdef OLED_0_66
        OLED_UI_add_SHOW_ICONINFO_task(OLED_UI_ICON_LED_STYLE_IDX, "Normal");
        OLED_UI_add_CANCELINFO_delay_task(2000);
#endif
        led_style_func = WS2812_Style_Normal;  // Fn+F6 - 背光使用固定亮度
#if (defined HAL_TPM) && (HAL_TPM == TRUE) && (defined HAL_HW_I2C) && (HAL_HW_I2C == TRUE)
        TPM_notify_backlight_data(BACKLIGHT_MODE_NORMAL);
#endif
        break;
      }
      case Fn_Mode_GiveUp: {
        Fn_cnt = 0;
        Fn_Mode = Fn_Mode_None;
        break;
      }
      default:  // 未识别的指令
        ;
    }
    last_state = 0;
    return 0;
  }
  return 1;
}

/*******************************************************************************
 * Function Name  : KEYBOARD_Init
 * Description    : 键盘初始化函数
 * Input          : None
 * Return         : None
 *******************************************************************************/
void KEYBOARD_Init( void )
{
    uint8_t i;
    DATAFLASH_Read_KeyArray( );   // DataFlash载入按键
    HAL_Fs_Read_keyboard_spkey((uint8_t*)SP_Key_Map);   // DataFlash载入spKEY
    CustomKey[5][6] = KEY_Fn;   // 保证上电Fn键在对应位置 - 其它键盘布局需修改此处

    for (i = 0; i < ROW_SIZE; i++) {
        Row_Pin_ALL |= Row_Pin[i];
    }
#if (ROW_SCAN_MODE)
    Row_GPIO_(ResetBits)( Row_Pin_ALL );
    Row_GPIO_(ModeCfg)( Row_Pin_ALL, GPIO_ModeOut_PP_5mA );
    Row_GPIO_(SetBits)( Row_Pin[0] );
#else
    Row_GPIO_(ResetBits)( Row_Pin_ALL );
    Row_GPIO_(ModeCfg)( Row_Pin_ALL, GPIO_ModeIN_PU );
#endif

    for (i = 0; i < COL_SIZE; i++) {
        Colum_Pin_ALL |= Colum_Pin[i];
    }
#if (ROW_SCAN_MODE)
    Colum_GPIO_(ResetBits)( Colum_Pin_ALL );
    Colum_GPIO_(ModeCfg)( Colum_Pin_ALL, GPIO_ModeIN_PD );
#else
    Colum_GPIO_(SetBits)( Colum_Pin_ALL );
    Colum_GPIO_(ModeCfg)( Colum_Pin_ALL, GPIO_ModeOut_PP_20mA );
    Colum_GPIO_(ResetBits)( Colum_Pin[0] );
#endif
    //初始化
    g_capslock_status.press_Capslock_NormalKey = FALSE; //是否单纯按下capslock,未使用其他快捷键
    g_capslock_status.press_Capslock = FALSE; //物理上 是否按下capslock
    g_capslock_status.press_Capslock_with_other = FALSE; //按下capslock时,是否按下其他键
}

/*******************************************************************************
 * Function Name  : KEYBOARD_Del_Key
 * Description    : 键盘删除按键
 * Input          : None
 * Return         : None
 *******************************************************************************/
void KEYBOARD_Del_Key(uint8_t key)
{
  if (key >= KEY_LeftCTRL && key <= KEY_RightGUI) {
    KeyboardDat->data[0] &= ~(1 << (key - KEY_LeftCTRL));
  } else {
    for (uint8_t i = 2; i < HID_KEYBOARD_DATA_LENGTH; i++) {
      if (KeyboardDat->data[i] != KEY_None && KeyboardDat->data[i] == key) {
        KeyboardDat->data[i] = KEY_None;
      }
    }
  }
}

/*******************************************************************************
 * Function Name  : KEYBOARD_Detection
 * Description    : 键盘检测按键信息函数
 * Input          : None
 * Return         : None
 *******************************************************************************/
void KEYBOARD_Detection( void )
{
#if (ROW_SCAN_MODE)
    static uint8_t current_row = 0;
    uint8_t current_colum;
#else
    static uint8_t current_colum = 0;
    uint8_t current_row;
#endif
    static uint8_t Touchbar_SP_Key = 0;  // 大于0表示触摸条被按下
    static uint8_t CapsLock_cnt = 0;  // 按下capslock后延迟弹起计数
    static BOOL press_Normal_Key = FALSE;
    uint8_t key_idx;
    mpr121_operation_data_t oper_dat;

    if (g_Game_Mode == FALSE) {
      MPR121_get_result(&oper_dat);
      /* 触摸条触发键盘按键相关 */
      if (oper_dat.slide_left == TRUE) {
          oper_dat.slide_left = FALSE;
          MPR121_set_result(&oper_dat);
          Touchbar_SP_Key = PRESS_HOLDING_TIMES;
          memcpy(KeyboardDat->data, SP_Key_Map[5], 8);  // KEY_SP_6
          g_Ready_Status.keyboard_key_data = TRUE;  // 产生事件
          return;
      } else if (oper_dat.slide_right == TRUE) {
          oper_dat.slide_right = FALSE;
          MPR121_set_result(&oper_dat);
          Touchbar_SP_Key = PRESS_HOLDING_TIMES;
          memcpy(KeyboardDat->data, SP_Key_Map[6], 8);  // KEY_SP_7
          g_Ready_Status.keyboard_key_data = TRUE;  // 产生事件
          return;
      } else if (Touchbar_SP_Key) {
          if (--Touchbar_SP_Key == 0) {  // 触摸条SP键的持续时间到达
              memset(KeyboardDat->data, 0, HID_KEYBOARD_DATA_LENGTH);
              g_Ready_Status.keyboard_key_data = TRUE;  // 产生事件
          }
          return;
      }
    }
    /* CapsLock功能相关 */
    if (CapsLock_cnt > 0) CapsLock_cnt--;
    if (g_capslock_status.press_Capslock_NormalKey && CapsLock_cnt == 0){ // 短按CapsLock后，弹起CapsLock
      g_capslock_status.press_Capslock_NormalKey = FALSE;
        for (key_idx = 2; key_idx < 8; key_idx++) {
            if (KeyboardDat->data[key_idx] == KEY_CapsLock) {
                KeyboardDat->data[key_idx] = 0;
            }
        }
        g_Ready_Status.keyboard_key_data = TRUE;  // 产生事件
        return;
    }
    /* 基础功能 */
#if (ROW_SCAN_MODE)
    for (current_colum = 0; current_colum < COL_SIZE; current_colum++) {    // 查询哪一列改变
        if (KeyMatrix[current_row][current_colum] == 0 && Colum_GPIO_(ReadPortPin)( Colum_Pin[current_colum] ) != 0) {  // 按下
#else
    for (current_row = 0; current_row < ROW_SIZE; current_row++) {    // 查询哪一行改变
        if (KeyMatrix[current_row][current_colum] == 0 && Row_GPIO_(ReadPortPin)( Row_Pin[current_row] ) == 0) {  // 按下
#endif
            if (g_keyboard_status.SP_Key != 0) continue;  // SP键生效后不接受其余按键
            KeyMatrix[current_row][current_colum] = 1;  // 矩阵状态变成按下
            if (led_style_func == WS2812_Style_Touch && Key_To_LEDNumber[current_row][current_colum] != 0xFF) { // 触控呼吸灯模式
                LED_BYTE_Buffer[Key_To_LEDNumber[current_row][current_colum]][0] =
                LED_BYTE_Buffer[Key_To_LEDNumber[current_row][current_colum]][1] =
                LED_BYTE_Buffer[Key_To_LEDNumber[current_row][current_colum]][2] = g_LED_brightness;
            }
            g_Ready_Status.keyboard_key_data = TRUE; // 产生事件

            if (g_capslock_status.press_Capslock && CustomKey[current_row][current_colum] != KEY_CapsLock) {
                g_capslock_status.press_Capslock_NormalKey = FALSE;
                g_capslock_status.press_Capslock_with_other = TRUE;
            } //按下capslock的同时 是否按下其他键

            uint8_t (*press_keyarr_ptr)[COL_SIZE] = KeyArr_Ptr;
            /* 自动鼠标键功能 */
            if (g_auto_mouse_control_time > 0) {
                press_keyarr_ptr = Extra_CustomKey;
            }

            if (press_keyarr_ptr[current_row][current_colum] == KEY_None) {  // 不做处理
                continue;
            } else if (press_keyarr_ptr[current_row][current_colum] == KEY_Fn) {  // 功能键
                g_keyboard_status.Fn = TRUE;
            } else if (press_keyarr_ptr[current_row][current_colum] == KEY_TP_MAP_SCROLL) {  // 小红点Y轴映射Z轴键
                HIDMouse[2] = 0;
                g_Enable_Status.tp_map_scroll = !g_Enable_Status.tp_map_scroll;
                if (g_Enable_Status.tp_map_scroll)
                  OLED_UI_add_SHOWINFO_task("tp y->z");
                else
                  OLED_UI_add_SHOWINFO_task("tp z->y");
                OLED_UI_add_CANCELINFO_delay_task(1500);
            } else if (press_keyarr_ptr[current_row][current_colum] >= KEY_SP_1) {  // SP键(单键复合)
                g_keyboard_status.SP_Key = press_keyarr_ptr[current_row][current_colum] - KEY_SP_1 + 1;
                press_Normal_Key = TRUE;
                memcpy(KeyboardDat->data, SP_Key_Map[g_keyboard_status.SP_Key - 1], 8);
            } else if (press_keyarr_ptr[current_row][current_colum] >= KEY_MouseL) {    // 鼠标操作
                MouseDat->data[0] |= 1 << press_keyarr_ptr[current_row][current_colum] - KEY_MouseL;
                press_Normal_Key = TRUE;
                g_Ready_Status.keyboard_mouse_data = TRUE;  // 产生鼠标事件
            } else if (press_keyarr_ptr[current_row][current_colum] >= KEY_LeftCTRL) {    // Ctrl等特殊键
                press_Normal_Key = TRUE;
                KeyboardDat->data[0] |= 1 << (press_keyarr_ptr[current_row][current_colum] - KEY_LeftCTRL);
            } else {
                press_Normal_Key = TRUE;
                if (CustomKey[current_row][current_colum] == KEY_CapsLock ) {  // CapsLock处理
                    KeyArr_Ptr = Extra_CustomKey;
                    g_capslock_status.press_Capslock = TRUE;
                } else {
                    for (key_idx = 2; key_idx < HID_KEYBOARD_DATA_LENGTH; key_idx++) {
                        if (KeyboardDat->data[key_idx] == KEY_None) {
                          KeyboardDat->data[key_idx] = press_keyarr_ptr[current_row][current_colum];
                          break;
                        }
                    }
                }
            }
#if (ROW_SCAN_MODE)
        } else if (KeyMatrix[current_row][current_colum] != 0 && Colum_GPIO_(ReadPortPin)( Colum_Pin[current_colum] ) == 0) {   // 弹起
#else
        } else if (KeyMatrix[current_row][current_colum] != 0 && Row_GPIO_(ReadPortPin)( Row_Pin[current_row] ) != 0) {   // 弹起
#endif
            KeyMatrix[current_row][current_colum] = 0;
            g_Ready_Status.keyboard_key_data = TRUE; // 产生事件
            uint8_t cur_key;
            /* 自动鼠标键功能 */
            if (g_auto_mouse_control_time > 0) {
                cur_key = Extra_CustomKey[current_row][current_colum];
            } else {
                cur_key = KeyArr_Ptr[current_row][current_colum];
            }

            if (cur_key == KEY_Fn) {  // 功能键
                g_keyboard_status.Fn = FALSE;
            } else if (cur_key >= KEY_SP_1) {  // SP键(单键复合)
                g_keyboard_status.SP_Key = 0;
                memset(KeyboardDat->data, 0, HID_KEYBOARD_DATA_LENGTH);
            } else if (cur_key >= KEY_MouseL) {    // 鼠标操作
                MouseDat->data[0] &= ~(1 << cur_key - KEY_MouseL);
                g_Ready_Status.keyboard_mouse_data = TRUE;  // 产生鼠标事件
            } else if (CustomKey[current_row][current_colum] == KEY_CapsLock) {  // 弹起大小写键离开Extra_CustomKey层
                KeyArr_Ptr = CustomKey;
                g_capslock_status.press_Capslock = FALSE;
                if (g_capslock_status.press_Capslock_with_other) { // 有使用其他层
                    g_capslock_status.press_Capslock_NormalKey = FALSE;
                    if (g_keyboard_status.SP_Key) { // 有使用SP键
                        g_keyboard_status.SP_Key = 0;
                        memset(KeyboardDat->data, 0, HID_KEYBOARD_DATA_LENGTH);
                        break;
                    }
                    g_capslock_status.press_Capslock_with_other = FALSE;
                } else { // 单纯按下capslock键
                    for (key_idx = 2; key_idx < HID_KEYBOARD_DATA_LENGTH; key_idx++) {
                        if (KeyboardDat->data[key_idx] == KEY_None) {
                          KeyboardDat->data[key_idx] = KEY_CapsLock;
                          break;
                        }
                    }
                    CapsLock_cnt = 3; // capslock会被按下直到该计数值为0后释放
                    g_capslock_status.press_Capslock_NormalKey = TRUE;
                }
            } else {  // Ctrl等特殊键 + 普通按键
                KEYBOARD_Del_Key(CustomKey[current_row][current_colum]);
                KEYBOARD_Del_Key(Extra_CustomKey[current_row][current_colum]);
            }
        }
    }
#if (ROW_SCAN_MODE)
    Row_GPIO_(ResetBits)( Row_Pin[current_row++] );
    if (current_row >= ROW_SIZE) {
        current_row = 0;
    }
    Row_GPIO_(SetBits)( Row_Pin[current_row] );
#else
    Colum_GPIO_(SetBits)( Colum_Pin[current_colum++] );
    if (current_colum >= COL_SIZE) {
        current_colum = 0;
    }
    Colum_GPIO_(ResetBits)( Colum_Pin[current_colum] );
#endif
}

/*******************************************************************************
 * Function Name  : KEYBOARD_EnterNumber
 * Description    : 键盘输入数字框
 * Input          : *key - 指向输入数字的指针
 *                  *preStr - 输入前的提示
 *                  *postStr - 输入完成的提示
 *                  limit_len - 限制长度(为0不限制, 最长24)
 * Return         : 返回0表示输入完成，返回0xFF表示清空输入
 *******************************************************************************/
uint8_t KEYBOARD_EnterNumber(uint32_t *key, const char* preStr, const char* postStr, uint8_t limit_len)
{
  static uint8_t idx = 0;
  static uint32_t passkey = 0;
  static char passkey_str[12] = { '\0' };
  const uint8_t keyhash[10] = { 1, 2, 3, 4, 5, 6, 7, 8, 9, 0 };
  if ( KeyboardDat->Key1 == KEY_BACKSPACE ) { // 退格单独处理
      if ( idx > 0 ) {
          passkey_str[--idx] = '\0';
          passkey /= 10;
      }
      if ( passkey_str[0] == '\0' ) {
        OLED_PRINT("%s", preStr);
      } else {
        OLED_PRINT("%s", passkey_str);
      }
  } else if ( KeyboardDat->Key1 == KEY_ENTER && (idx == limit_len || limit_len == 0) ) {  // 最后一个按键是Enter则结束
      OLED_PRINT("%s", postStr);
      *key = passkey;
      passkey = idx = passkey_str[0] = 0;
      return 0;
  } else if ( KeyboardDat->Key1 >= KEY_1 && KeyboardDat->Key1 <= KEY_0 ){
      passkey = passkey * 10 + keyhash[KeyboardDat->Key1 - KEY_1];
      passkey_str[idx++] = keyhash[KeyboardDat->Key1 - KEY_1] + 0x30;
      passkey_str[idx] = '\0';
      OLED_PRINT("%s", passkey_str);
  } else if ( KeyboardDat->Key1 == KEY_ESCAPE ){  // Esc清空输入项
      passkey = idx = passkey_str[0] = 0;
      OLED_PRINT("%s", preStr);
      return 0xFF;
  }
  return 1;
}
