linlingwanqing-commits/tp78_v2/mounriver_project/KEYBOARD_CH582M/HAL/include/FATFS.h

/********************************** (C) COPYRIGHT *******************************
 * File Name          : FATFS.h
 * Author             : ChnMasterOG
 * Version            : V1.0
 * Date               : 2023/2/5
 * Description        : FatFs应用层驱动
 * Copyright (c) 2023 ChnMasterOG
 * SPDX-License-Identifier: GPL-3.0
 *******************************************************************************/

#ifndef __FATFS_H
  #define __FATFS_H

  #include "CH58x_common.h"

  #define FS_LINE_START                   0
  #define FS_LINE_BLE_DEVICE              0
  #define FS_LINE_LED_STYLE               1
  #define FS_LINE_WORK_MODE               2
  #define FS_LINE_UDISK_MODE              3
  #define FS_LINE_MPR_ALG_MAGIC           4
  #define FS_LINE_MPR_CAPMOUSE_TOU_THR    5
  #define FS_LINE_MPR_CAPMOUSE_REL_THR    6
  #define FS_LINE_MPR_CAPMOUSE_MOV_SPD    7
  #define FS_LINE_MPR_TOUCHBAR_TOU_THR    8
  #define FS_LINE_MPR_TOUCHBAR_REL_THR    9
  #define FS_LINE_MPR_DOUBLE_TOUCH_CNT    10
  #define FS_LINE_MPR_LONG_TOUCH_CNT      11
  #define FS_LINE_TP_SPEED_DIV            12
  #define FS_LINE_LED_BRIGHTNESS          13
  #define FS_LINE_RF_FREQ_LEVEL           14
  #define FS_LINE_TOUCHBAR_BUTTON_CTL_ENA 15
  #define FS_LINE_IDLE_MAX_CNT            16
  #define FS_LINE_LP_MAX_CNT              17
  #define FS_LINE_RF_CHECK_ACK_MS         18
  #define FS_LINE_ENABLE_MOTOR            19
  #define FS_LINE_AUTO_MOUSE_CLICK        20
  #define FS_LINE_CURRENT_SYS             21

  uint8_t unsigned_dec_to_string(uint16_t num, char *buff, uint8_t type);
  uint8_t string_dec_to_u16(char *buff, uint16_t *num);
  uint8_t string_dec_to_u8(char *buff, uint8_t *num);

  void HAL_Fs_Init(void);
  void HAL_Fs_Create_readme(void);
  void HAL_Fs_Create_keyboard_cfg(uint8_t len, uint16_t* p_cfg);
  void HAL_Fs_Write_keyboard_cfg(uint8_t fs_line, uint8_t len, uint16_t* p_cfg);
  void HAL_Fs_Read_keyboard_cfg(uint8_t fs_line, uint8_t len, uint16_t* p_cfg);
  void HAL_Fs_Write_ble_device_info(BLE_Device_Info_t *ble_device_info);
  void HAL_Fs_Read_ble_device_info(BLE_Device_Info_t *ble_device_info);
  void HAL_Fs_Write_keyboard_spkey(uint8_t* hid_arr);
  void HAL_Fs_Read_keyboard_spkey(uint8_t* hid_arr);
  void HAL_Fs_Write_keyboard_mat(const uint8_t* fp, const uint8_t* key_arr);
  void HAL_Fs_Read_keyboard_mat(const uint8_t* fp, uint8_t* key_arr);

#endif
